jull-taragan/Hardware/resources/300ppi/podPinout.png

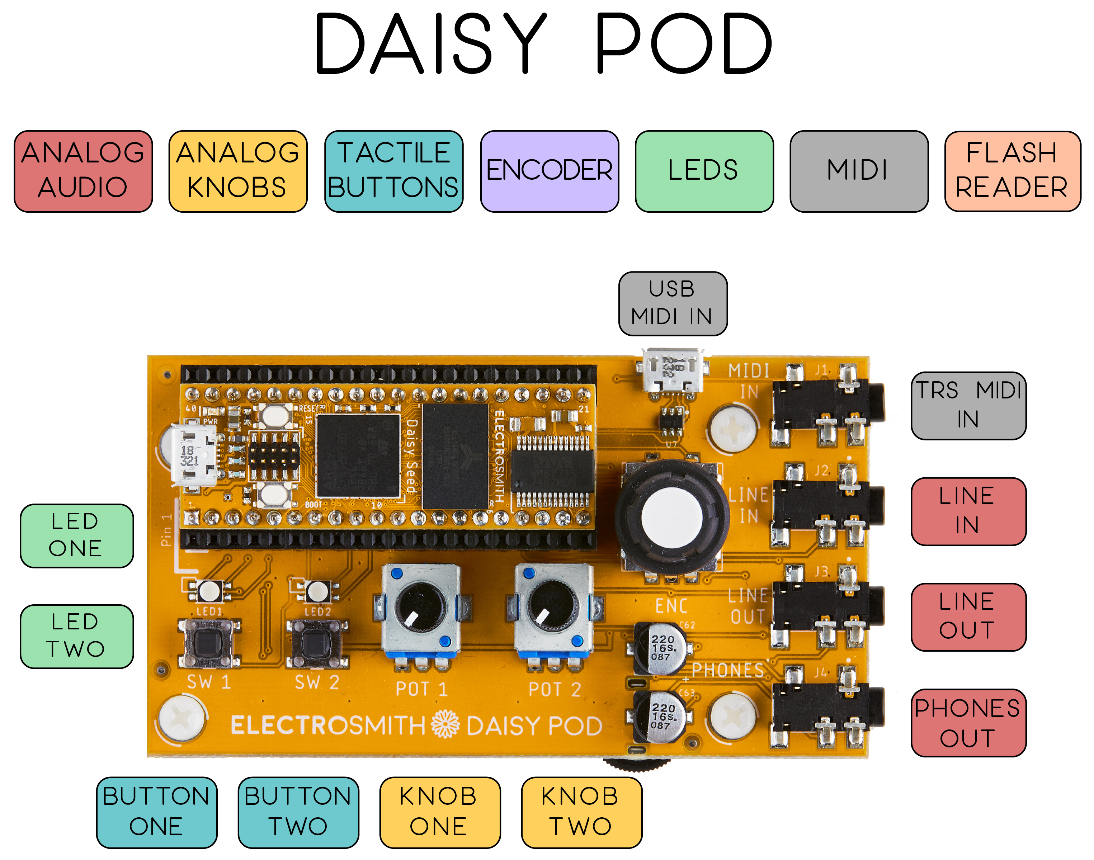
resources/300ppi/podPinout.png
