jull-taragan/Hardware/README.md

## Hardware

Documentation and reference circuits for Electrosmith submodules and boards including the [Daisy Embedded Audio Platform.](https://www.electro-smith.com/daisy)

### Features

- Reference schematics for existing hardware designs

- Documentation including datasheets and app notes

- EAGLE files for hardware examples

- Fritzing breadboard diagrams and schematics (coming soon)

### Getting Started
- Check out our [Getting Started wiki page](https://github.com/electro-smith/DaisyWiki/wiki/1.-Getting-Started)
- Make some sound!

### Contributing

Here are some ways that you can get involved:
- Proof read the documentation and suggest improvements
- Make Fritzing breadboard diagrams for common circuits
- Submit your own hardware examples for inclusion to the repo

### Support

Here are some ways to get support and connect with other users and developers:

- [Make an issue](https://github.com/electro-smith/hardware/issues) 

- Slack Workspace - shoot us an email at hello(at)electro-smith(dot)com to receive an invitation

- Tech Support - for the best response, please use our [contact form](https://www.electro-smith.com/contact)

- Forum (Coming soon)

### License
This repository is licensed with the permissive MIT open source license. 

This allows for modification and reuse in both commercial and personal projects. 
It does not provide a warranty of any kind. 

For the full license, read the [LICENSE](https://github.com/electro-smith/hardware/blob/master/LICENSE) file in the root directory.
