jull-taragan/Hardware/(list of files, drawings)

Other design files:
examples/DaisySeedBlink.fzz
