jull-taragan/Hardware/reference/daisy_patch/ES_Daisy_Patch_Rev4.sch

## EAGLE design reference/daisy_patch/ES_Daisy_Patch_Rev4.sch (2020-06-08)

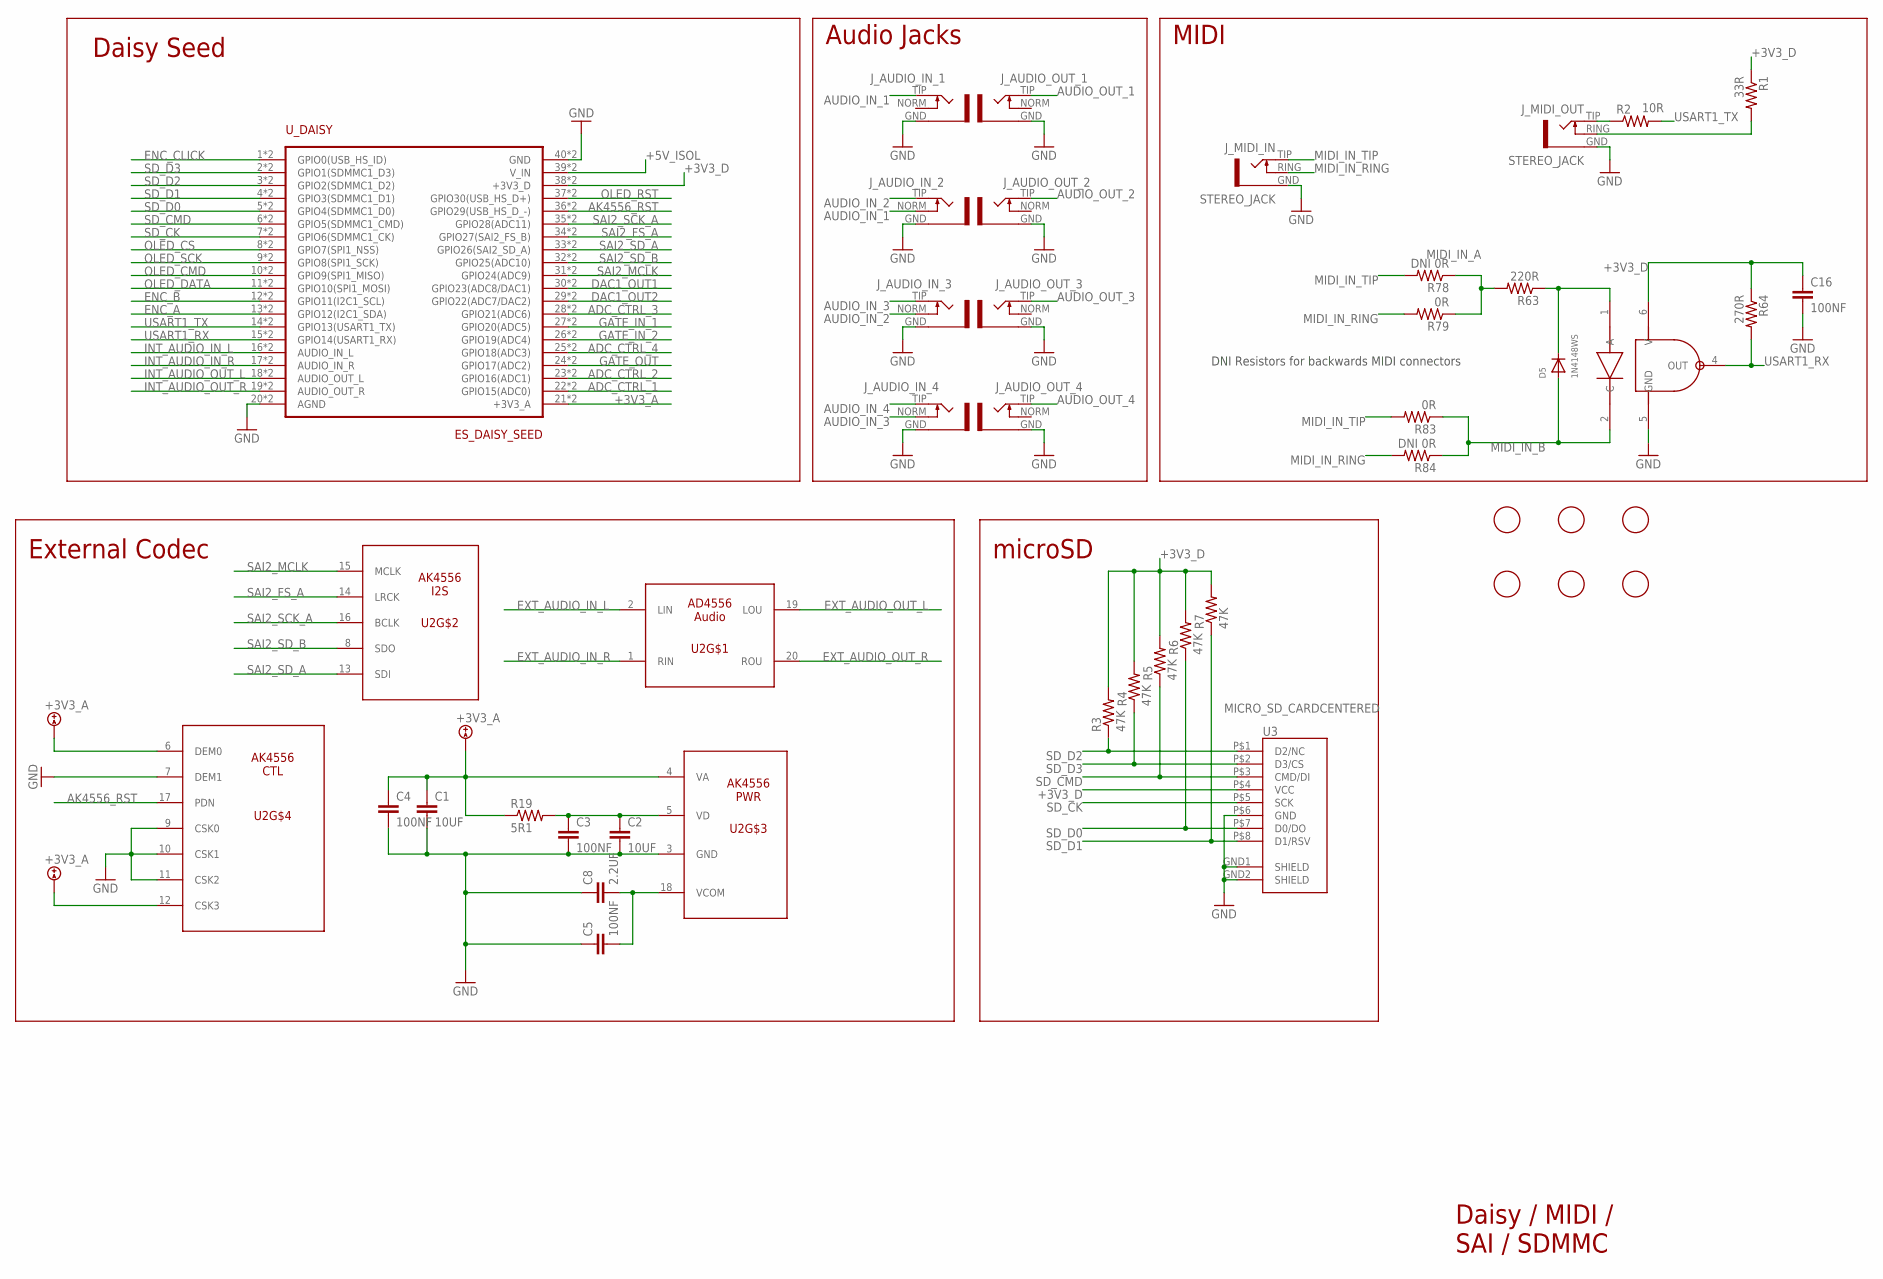
[picture p2: schematic ES_Daisy_Patch_Rev4.sch, sheet 1]

Parts:
C1, C2: 10UF; C0805
C3, C4, C5, C16: 100NF; C0603
C8: 2.2UF; C0603
D5: 1N4148WS; SOD-323F
FD1, FD2, FD3, FD4, FD5, FD6: FIDUCIAL; FIDUCIAL_1MM
J_AUDIO_IN_1, J_AUDIO_IN_2, J_AUDIO_IN_3, J_AUDIO_IN_4: EURO_JACK; S_JACK
J_AUDIO_OUT_1, J_AUDIO_OUT_2, J_AUDIO_OUT_3, J_AUDIO_OUT_4: EURO_JACK; S_JACK
J_MIDI_IN: STEREO_JACK; STEREO_JACK_3.5MM
J_MIDI_OUT: STEREO_JACK; STEREO_JACK_3.5MM
R1: 33R; R0603
R2: 10R; R0603
R3, R4, R5, R6, R7: 47K; R0603
R19: 5R1; R0603
R63: 220R; R0603
R64: 270R; R0603
R78, R84: DNI 0R; R0603
R79, R83: 0R; R0603
U2: AK4556; TSSOP20
U3: MICRO_SD_CARDCENTERED; VERT_MICROSD_CENTERED
U15: OPTOISOLATOR_H11L1M; DIL06_GULLWING
U_DAISY: ES_DAISY_SEED; ES_DAISY_SEED_DOUBLE

Connections:
+3V3_A: C1.1, C4.1, R19.1, U2.4 (VA), U2.6 (DEM0), U2.12 (CSK3), U_DAISY.21 (+3V3_A)
+3V3_D: C16.1, R1.1, R3.2, R4.2, R5.2, R6.2, R7.2, R64.1, U3.P$4 (VCC), U15.6 (V), U_DAISY.38 (+3V3_D)
+5V_ISOL: U_DAISY.39 (V_IN)
ADC_CTRL_1: U_DAISY.22 (GPIO15(ADC0))
ADC_CTRL_2: U_DAISY.23 (GPIO16(ADC1))
ADC_CTRL_3: U_DAISY.28 (GPIO21(ADC6))
ADC_CTRL_4: U_DAISY.25 (GPIO18(ADC3))
AK4556_RST: U2.17 (PDN), U_DAISY.36 (GPIO29(USB_HS_D_-))
AUDIO_IN_1: J_AUDIO_IN_1.TIP, J_AUDIO_IN_2.NORM
AUDIO_IN_2: J_AUDIO_IN_2.TIP, J_AUDIO_IN_3.NORM
AUDIO_IN_3: J_AUDIO_IN_3.TIP, J_AUDIO_IN_4.NORM
AUDIO_IN_4: J_AUDIO_IN_4.TIP
AUDIO_OUT_1: J_AUDIO_OUT_1.TIP
AUDIO_OUT_2: J_AUDIO_OUT_2.TIP
AUDIO_OUT_3: J_AUDIO_OUT_3.TIP
AUDIO_OUT_4: J_AUDIO_OUT_4.TIP
DAC1_OUT1: U_DAISY.30 (GPIO23(ADC8/DAC1))
DAC1_OUT2: U_DAISY.29 (GPIO22(ADC7/DAC2))
ENC_A: U_DAISY.13 (GPIO12(I2C1_SDA))
ENC_B: U_DAISY.12 (GPIO11(I2C1_SCL))
ENC_CLICK: U_DAISY.1 (GPIO0(USB_HS_ID))
EXT_AUDIO_IN_L: U2.2 (LIN)
EXT_AUDIO_IN_R: U2.1 (RIN)
EXT_AUDIO_OUT_L: U2.19 (LOU)
EXT_AUDIO_OUT_R: U2.20 (ROU)
GATE_IN_1: U_DAISY.27 (GPIO20(ADC5))
GATE_IN_2: U_DAISY.26 (GPIO19(ADC4))
GATE_OUT: U_DAISY.24 (GPIO17(ADC2))
GND: C1.2, C2.2, C3.2, C4.2, C5.1, C8.1, C16.2, J_AUDIO_IN_1.GND, J_AUDIO_IN_2.GND, J_AUDIO_IN_3.GND, J_AUDIO_IN_4.GND, J_AUDIO_OUT_1.GND, J_AUDIO_OUT_2.GND, J_AUDIO_OUT_3.GND, J_AUDIO_OUT_4.GND, J_MIDI_IN.GND, J_MIDI_OUT.GND, U2.3 (GND), U2.7 (DEM1), U2.9 (CSK0), U2.10 (CSK1), U2.11 (CSK2), U3.GND1 (SHIELD), U3.GND2 (SHIELD), U3.P$6 (GND), U15.5 (GND), U_DAISY.20 (AGND), U_DAISY.40 (GND)
INT_AUDIO_IN_L: U_DAISY.16 (AUDIO_IN_L)
INT_AUDIO_IN_R: U_DAISY.17 (AUDIO_IN_R)
INT_AUDIO_OUT_L: U_DAISY.18 (AUDIO_OUT_L)
INT_AUDIO_OUT_R: U_DAISY.19 (AUDIO_OUT_R)
MIDI_IN_A: R63.2, R78.1, R79.1
MIDI_IN_B: D5.A, R83.1, R84.1, U15.2 (C)
MIDI_IN_RING: J_MIDI_IN.RING (NORM), R79.2, R84.2
MIDI_IN_TIP: J_MIDI_IN.TIP, R78.2, R83.2
unnamed: J_MIDI_OUT.TIP, R2.1
unnamed: J_MIDI_OUT.RING (NORM), R1.2
unnamed: C2.1, C3.1, R19.2, U2.5 (VD)
unnamed: C5.2, C8.2, U2.18 (VCOM)
unnamed: D5.C, R63.1, U15.1 (A)
OLED_CMD: U_DAISY.10 (GPIO9(SPI1_MISO))
OLED_CS: U_DAISY.8 (GPIO7(SPI1_NSS))
OLED_DATA: U_DAISY.11 (GPIO10(SPI1_MOSI))
OLED_RST: U_DAISY.37 (GPIO30(USB_HS_D+))
OLED_SCK: U_DAISY.9 (GPIO8(SPI1_SCK))
SAI2_FS_A: U2.14 (LRCK), U_DAISY.34 (GPIO27(SAI2_FS_B))
SAI2_MCLK: U2.15 (MCLK), U_DAISY.31 (GPIO24(ADC9))
SAI2_SCK_A: U2.16 (BCLK), U_DAISY.35 (GPIO28(ADC11))
SAI2_SD_A: U2.13 (SDI), U_DAISY.33 (GPIO26(SAI2_SD_A))
SAI2_SD_B: U2.8 (SDO), U_DAISY.32 (GPIO25(ADC10))
SD_CK: U3.P$5 (SCK), U_DAISY.7 (GPIO6(SDMMC1_CK))
SD_CMD: R5.1, U3.P$3 (CMD/DI), U_DAISY.6 (GPIO5(SDMMC1_CMD))
SD_D0: R6.1, U3.P$7 (D0/DO), U_DAISY.5 (GPIO4(SDMMC1_D0))
SD_D1: R7.1, U3.P$8 (D1/RSV), U_DAISY.4 (GPIO3(SDMMC1_D1))
SD_D2: R3.1, U3.P$1 (D2/NC), U_DAISY.3 (GPIO2(SDMMC1_D2))
SD_D3: R4.1, U3.P$2 (D3/CS), U_DAISY.2 (GPIO1(SDMMC1_D3))
USART1_RX: R64.2, U15.4 (OUT), U_DAISY.15 (GPIO14(USART1_RX))
USART1_TX: R2.2, U_DAISY.14 (GPIO13(USART1_TX))

Notes on the sheet:
Daisy Seed
Audio Jacks
External Codec
MIDI
microSD
Daisy / MIDI / SAI / SDMMC
DNI Resistors for backwards MIDI connectors

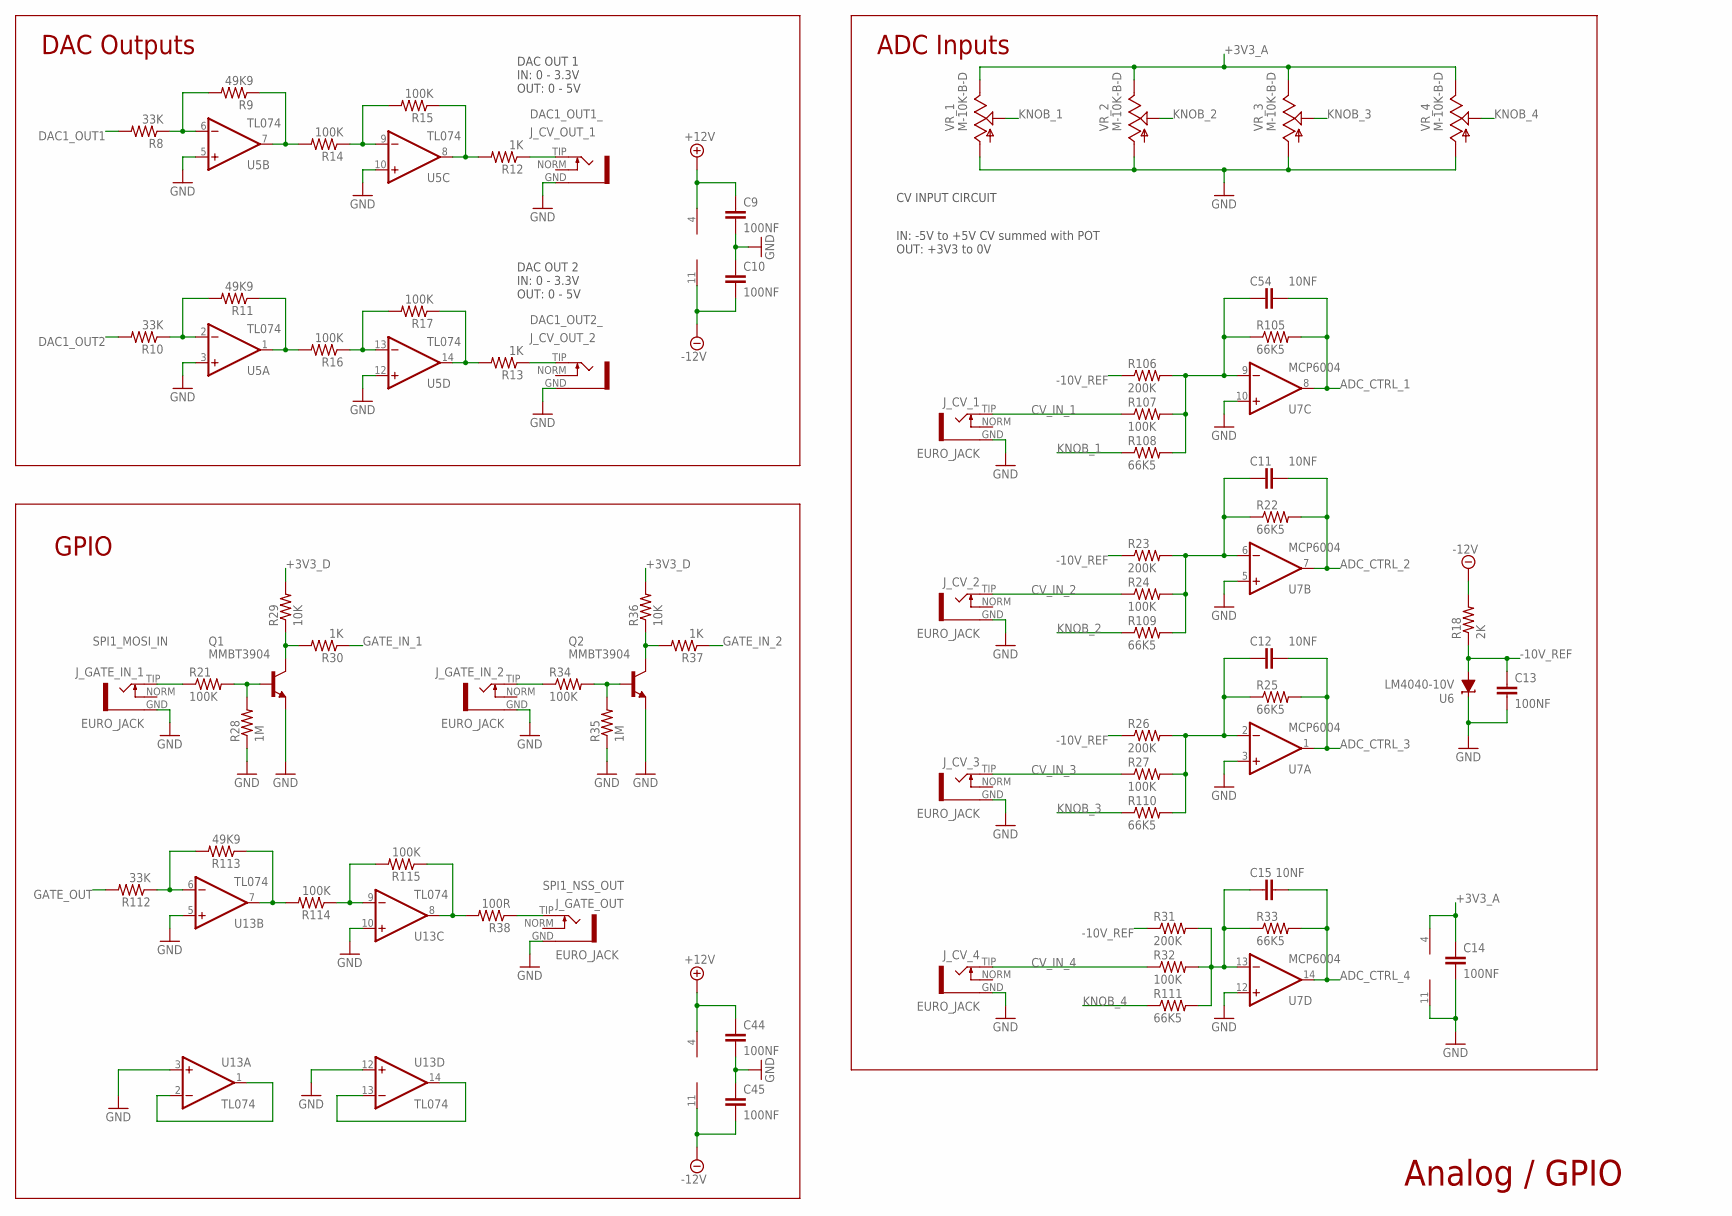
[picture p3: schematic ES_Daisy_Patch_Rev4.sch, sheet 2]

Parts:
C9, C10, C13, C14, C44, C45: 100NF; C0603
C11, C12, C15, C54: 10NF; C0603
J_CV_1, J_CV_2, J_CV_3, J_CV_4: EURO_JACK; S_JACK
J_CV_OUT_1, J_CV_OUT_2: EURO_JACK; S_JACK
J_GATE_IN_1, J_GATE_IN_2: EURO_JACK; S_JACK
J_GATE_OUT: EURO_JACK; S_JACK
Q1, Q2: MMBT3904; SOT23-BEC
R8, R10, R112: 33K; R0603
R9, R11, R113: 49K9; R0603
R12, R13, R30, R37: 1K; R0603
R14, R15, R16, R17, R21, R24, R27, R32, R34, R107, R114, R115: 100K; R0603
R18: 2K; R0603
R22, R25, R33, R105, R108, R109, R110, R111: 66K5; R0603
R23, R26, R31, R106: 200K; R0603
R28, R35: 1M; R0603
R29, R36: 10K; R0603
R38: 100R; R0603
U5, U13: TL074; TSSOP-14
U6: LM4040-10V; DBZ_R-PDSO-G3
U7: MCP6004; TSSOP-14
VR_1, VR_2, VR_3, VR_4: M-10K-B-D; 9MM_SNAP-IN_POT_SILK

Connections:
+3V3_A: C14.1, U7.4 (V+), VR_1.3, VR_2.3, VR_3.3, VR_4.3
+3V3_D: R29.2, R36.2
+12V: C9.1, C44.1, U5.4 (V+), U13.4 (V+)
-10V_REF: C13.1, R18.1, R23.1, R26.1, R31.1, R106.1, U6.2 (A)
-12V: C10.2, C45.2, R18.2, U5.11 (V-), U13.11 (V-)
ADC_CTRL_1: C54.2, R105.2, U7.8 (OUT)
ADC_CTRL_2: C11.2, R22.2, U7.7 (OUT)
ADC_CTRL_3: C12.2, R25.2, U7.1 (OUT)
ADC_CTRL_4: C15.2, R33.2, U7.14 (OUT)
CV_IN_1: J_CV_1.TIP, R107.1
CV_IN_2: J_CV_2.TIP, R24.1
CV_IN_3: J_CV_3.TIP, R27.1
CV_IN_4: J_CV_4.TIP, R32.1
DAC1_OUT1: R8.2
DAC1_OUT1_: J_CV_OUT_1.TIP, R12.1
DAC1_OUT2: R10.2
DAC1_OUT2_: J_CV_OUT_2.TIP, R13.1
GATE_IN_1: R30.1
GATE_IN_2: R37.1
GATE_OUT: R112.2
GND: C9.2, C10.1, C13.2, C14.2, C44.2, C45.1, J_CV_1.GND, J_CV_2.GND, J_CV_3.GND, J_CV_4.GND, J_CV_OUT_1.GND, J_CV_OUT_2.GND, J_GATE_IN_1.GND, J_GATE_IN_2.GND, J_GATE_OUT.GND, Q1.E, Q2.E, R28.1, R35.1, U5.3 (+IN), U5.5 (+IN), U5.10 (+IN), U5.12 (+IN), U6.1 (C), U7.3 (+IN), U7.5 (+IN), U7.10 (+IN), U7.11 (V-), U7.12 (+IN), U13.3 (+IN), U13.5 (+IN), U13.10 (+IN), U13.12 (+IN), VR_1.1, VR_2.1, VR_3.1, VR_4.1
KNOB_1: R108.1, VR_1.2
KNOB_2: R109.1, VR_2.2
KNOB_3: R110.1, VR_3.2
KNOB_4: R111.1, VR_4.2
unnamed: R14.1, R15.2, U5.9 (-IN)
unnamed: R12.2, R15.1, U5.8 (OUT)
unnamed: R8.1, R9.2, U5.6 (-IN)
unnamed: R9.1, R14.2, U5.7 (OUT)
unnamed: C54.1, R105.1, R106.2, R107.2, R108.2, U7.9 (-IN)
unnamed: R10.1, R11.2, U5.2 (-IN)
unnamed: R11.1, R16.2, U5.1 (OUT)
unnamed: R112.1, R113.2, U13.6 (-IN)
unnamed: R16.1, R17.2, U5.13 (-IN)
unnamed: R13.2, R17.1, U5.14 (OUT)
unnamed: U13.1 (OUT), U13.2 (-IN)
unnamed: R113.1, R114.2, U13.7 (OUT)
unnamed: R114.1, R115.2, U13.9 (-IN)
unnamed: R38.2, R115.1, U13.8 (OUT)
unnamed: Q1.C, R29.1, R30.2
unnamed: C11.1, R22.1, R23.2, R24.2, R109.2, U7.6 (-IN)
unnamed: Q2.B, R34.2, R35.2
unnamed: C12.1, R25.1, R26.2, R27.2, R110.2, U7.2 (-IN)
unnamed: Q1.B, R21.2, R28.2
unnamed: Q2.C, R36.1, R37.2
unnamed: C15.1, R31.2, R32.2, R33.1, R111.2, U7.13 (-IN)
unnamed: U13.13 (-IN), U13.14 (OUT)
SPI1_MISO_IN: J_GATE_IN_2.TIP, R34.1
SPI1_MOSI_IN: J_GATE_IN_1.TIP, R21.1
SPI1_NSS_OUT: J_GATE_OUT.TIP, R38.1

Notes on the sheet:
DAC Outputs
DAC OUT 1 IN: 0 - 3.3V OUT: 0 - 5V
DAC OUT 2 IN: 0 - 3.3V OUT: 0 - 5V
ADC Inputs
GPIO
IN: -5V to +5V CV summed with POT OUT: +3V3 to 0V
CV INPUT CIRCUIT
Analog / GPIO

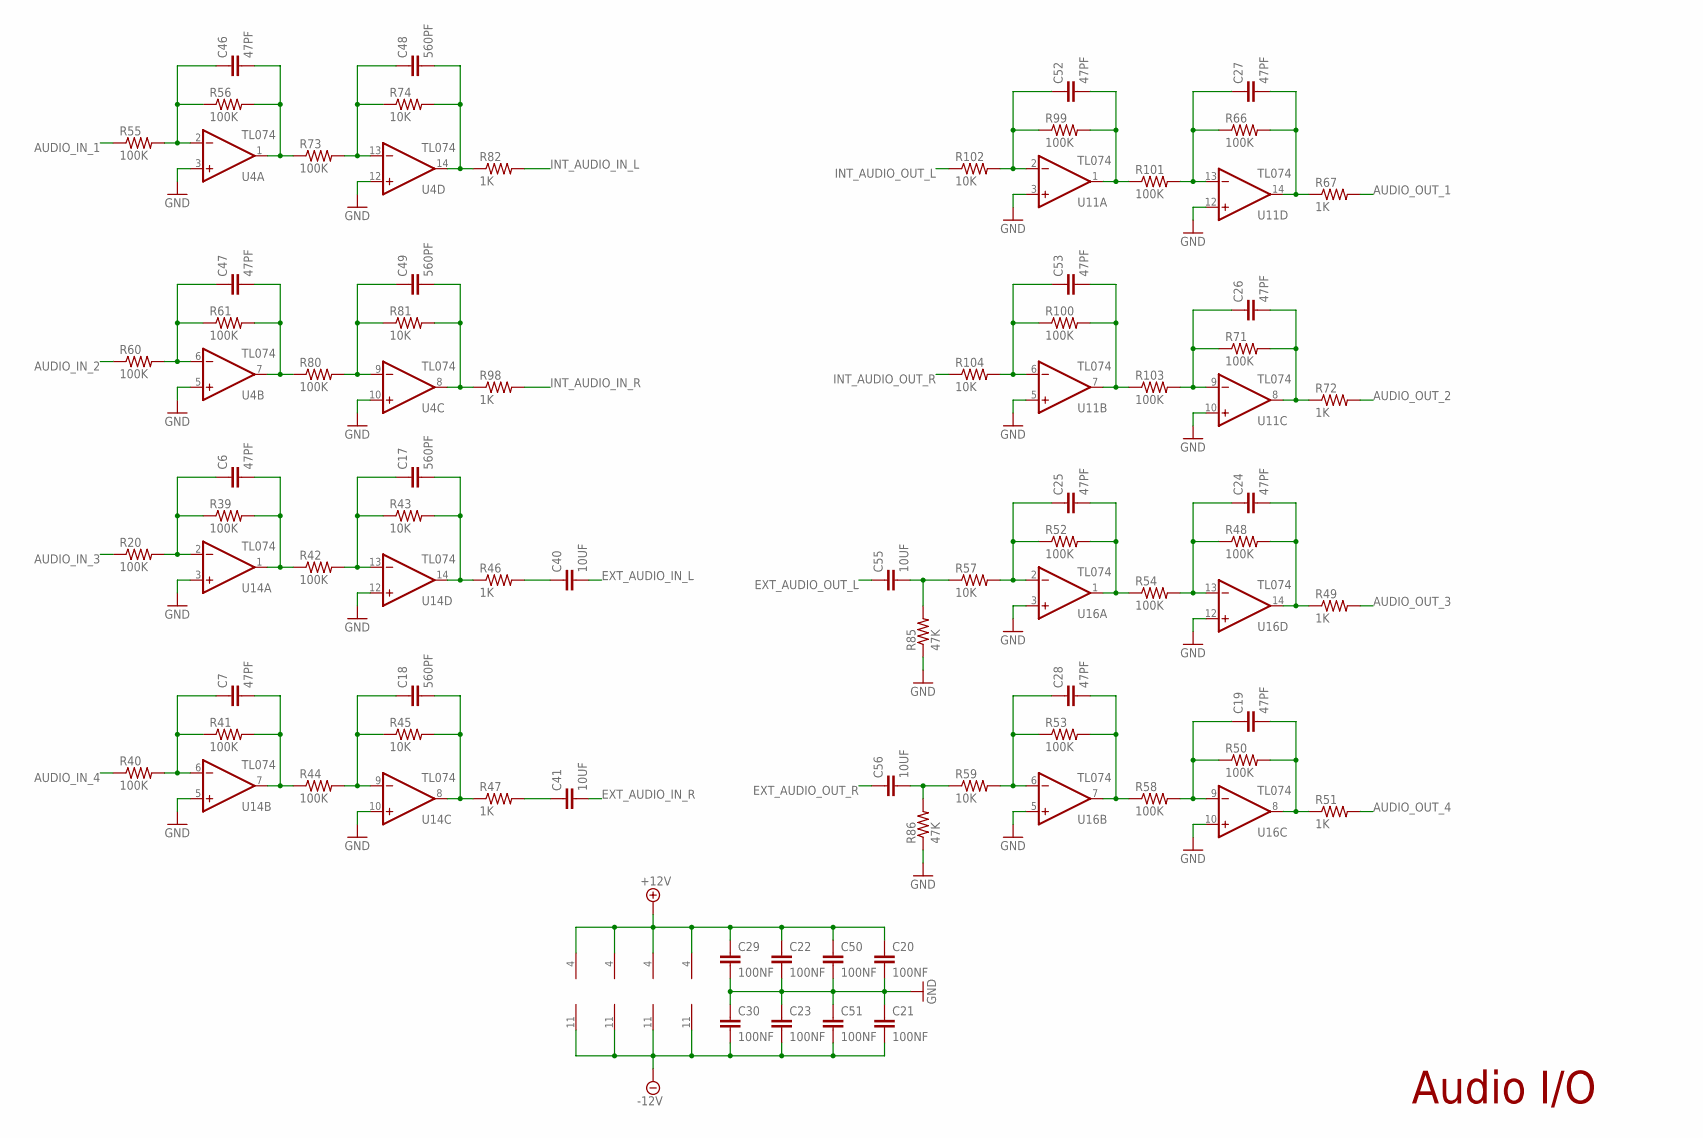
[picture p4: schematic ES_Daisy_Patch_Rev4.sch, sheet 3]

Parts:
C6, C7, C19, C24, C25, C26, C27, C28, C46, C47, C52, C53: 47PF; C0603
C17, C18, C48, C49: 560PF; C0603
C20, C21, C22, C23, C29, C30, C50, C51: 100NF; C0603
C40, C41, C55, C56: 10UF; C0805
R20, R39, R40, R41, R42, R44, R48, R50, R52, R53, R54, R55, R56, R58, R60, R61, R66, R71, R73, R80, R99, R100, R101, R103: 100K; R0603
R43, R45, R57, R59, R74, R81, R102, R104: 10K; R0603
R46, R47, R49, R51, R67, R72, R82, R98: 1K; R0603
R85, R86: 47K; R0603
U4, U11, U14, U16: TL074; TSSOP-14

Connections:
+12V: C20.1, C22.1, C29.1, C50.1, U4.4 (V+), U11.4 (V+), U14.4 (V+), U16.4 (V+)
-12V: C21.2, C23.2, C30.2, C51.2, U4.11 (V-), U11.11 (V-), U14.11 (V-), U16.11 (V-)
AUDIO_IN_1: R55.1
AUDIO_IN_2: R60.1
AUDIO_IN_3: R20.1
AUDIO_IN_4: R40.1
AUDIO_OUT_1: R67.2
AUDIO_OUT_2: R72.2
AUDIO_OUT_3: R49.2
AUDIO_OUT_4: R51.2
EXT_AUDIO_IN_L: C40.2
EXT_AUDIO_IN_R: C41.2
EXT_AUDIO_OUT_L: C55.1
EXT_AUDIO_OUT_R: C56.1
GND: C20.2, C21.1, C22.2, C23.1, C29.2, C30.1, C50.2, C51.1, R85.1, R86.1, U4.3 (+IN), U4.5 (+IN), U4.10 (+IN), U4.12 (+IN), U11.3 (+IN), U11.5 (+IN), U11.10 (+IN), U11.12 (+IN), U14.3 (+IN), U14.5 (+IN), U14.10 (+IN), U14.12 (+IN), U16.3 (+IN), U16.5 (+IN), U16.10 (+IN), U16.12 (+IN)
INT_AUDIO_IN_L: R82.2
INT_AUDIO_IN_R: R98.2
INT_AUDIO_OUT_L: R102.1
INT_AUDIO_OUT_R: R104.1
unnamed: C40.1, R46.2
unnamed: C7.1, R40.2, R41.1, U14.6 (-IN)
unnamed: C7.2, R41.2, R44.1, U14.7 (OUT)
unnamed: C48.1, R73.2, R74.1, U4.13 (-IN)
unnamed: C6.1, R20.2, R39.1, U14.2 (-IN)
unnamed: C6.2, R39.2, R42.1, U14.1 (OUT)
unnamed: C17.1, R42.2, R43.1, U14.13 (-IN)
unnamed: C18.1, R44.2, R45.1, U14.9 (-IN)
unnamed: C18.2, R45.2, R47.1, U14.8 (OUT)
unnamed: C17.2, R43.2, R46.1, U14.14 (OUT)
unnamed: C19.1, R50.1, R58.2, U16.9 (-IN)
unnamed: C19.2, R50.2, R51.1, U16.8 (OUT)
unnamed: C24.1, R48.1, R54.2, U16.13 (-IN)
unnamed: C24.2, R48.2, R49.1, U16.14 (OUT)
unnamed: C25.1, R52.1, R57.2, U16.2 (-IN)
unnamed: C25.2, R52.2, R54.1, U16.1 (OUT)
unnamed: C28.1, R53.1, R59.2, U16.6 (-IN)
unnamed: C28.2, R53.2, R58.1, U16.7 (OUT)
unnamed: C41.1, R47.2
unnamed: C55.2, R57.1, R85.2
unnamed: C56.2, R59.1, R86.2
unnamed: C46.1, R55.2, R56.1, U4.2 (-IN)
unnamed: C46.2, R56.2, R73.1, U4.1 (OUT)
unnamed: C47.1, R60.2, R61.1, U4.6 (-IN)
unnamed: C47.2, R61.2, R80.1, U4.7 (OUT)
unnamed: C27.1, R66.1, R101.2, U11.13 (-IN)
unnamed: C27.2, R66.2, R67.1, U11.14 (OUT)
unnamed: C49.1, R80.2, R81.1, U4.9 (-IN)
unnamed: C26.1, R71.1, R103.2, U11.9 (-IN)
unnamed: C26.2, R71.2, R72.1, U11.8 (OUT)
unnamed: C49.2, R81.2, R98.1, U4.8 (OUT)
unnamed: C48.2, R74.2, R82.1, U4.14 (OUT)
unnamed: C52.1, R99.1, R102.2, U11.2 (-IN)
unnamed: C52.2, R99.2, R101.1, U11.1 (OUT)
unnamed: C53.1, R100.1, R104.2, U11.6 (-IN)
unnamed: C53.2, R100.2, R103.1, U11.7 (OUT)

Notes on the sheet:
Audio I/O

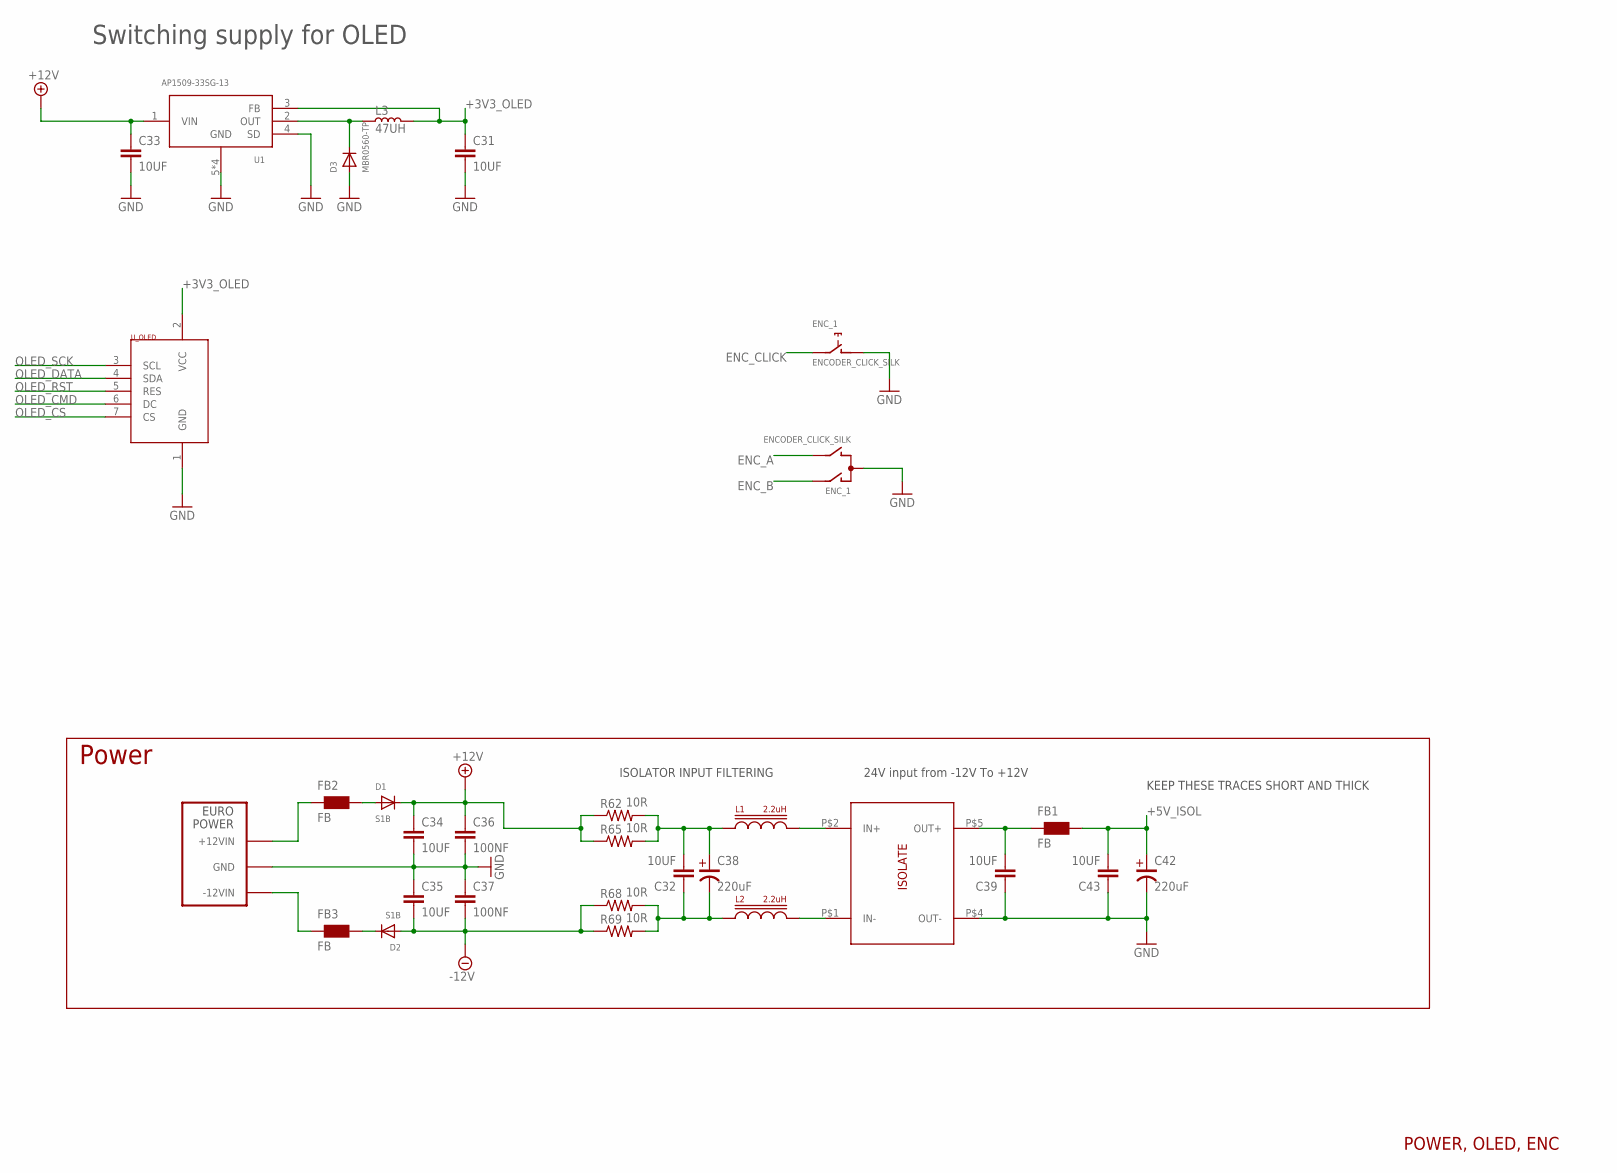
[picture p5: schematic ES_Daisy_Patch_Rev4.sch, sheet 4]

Parts:
C31, C32, C33, C34, C35, C39, C43: 10UF; C0805
C36, C37: 100NF; C0603
C38, C42: 220uF; PANASONIC_D
D1, D2: S1B; SMADIODE
D3: MBR0560-TP; SOD-123
ENC_1: ENCODER_CLICK_SILK; PEC11_SILK
EP1: EURORACK_POWERSMT; EURORACK_POWER_SMT
FB1, FB2, FB3: FB; WUERTH-ELEKTRONIK_0603
L1, L2: 2.2uH; BOURNS_SRP2010
L3: 47UH; SRN3015TA
R62, R65, R68, R69: 10R; R0603
U1: AP1509-33SG-13; SO-8
U$1: POWER_ISOLATE; XP_POWER_ISEXXXXA
U_OLED: OLED_DISPLAY; ER-OLEDM015-2

Connections:
+3V3_OLED: C31.1, L3.P$2, U1.3 (FB), U_OLED.2 (VCC)
+5V_ISOL: C42.+ (POS), C43.2, FB1.2
+12V: C33.1, C34.1, C36.1, D1.C, R62.1, R65.1, U1.1 (VIN)
-12V: C35.2, C37.2, D2.A, R68.1, R69.1
ENC_A: ENC_1.B
ENC_B: ENC_1.A
ENC_CLICK: ENC_1.E (2)
GND: C31.2, C33.2, C34.2, C35.1, C36.2, C37.1, C39.1, C42.- (NEG), C43.1, D3.A, ENC_1.C, ENC_1.D (1), EP1.GND1A (GND), U1.4 (SD), U1.5 (GND), U$1.P$4 (OUT-), U_OLED.1 (GND)
unnamed: C39.2, FB1.1, U$1.P$5 (OUT+)
unnamed: L1.P$2, U$1.P$2 (IN+)
unnamed: L2.P$2, U$1.P$1 (IN-)
unnamed: C32.2, C38.+ (POS), L1.P$1, R62.2, R65.2
unnamed: C32.1, C38.- (NEG), L2.P$1, R68.2, R69.2
unnamed: EP1.P12VA (+12VIN), FB2.1
unnamed: D3.C, L3.P$1, U1.2 (OUT)
unnamed: EP1.N12VA (-12VIN), FB3.1
unnamed: D1.A, FB2.2
unnamed: D2.C, FB3.2
OLED_CMD: U_OLED.6 (DC)
OLED_CS: U_OLED.7 (CS)
OLED_DATA: U_OLED.4 (SDA)
OLED_RST: U_OLED.5 (RES)
OLED_SCK: U_OLED.3 (SCL)

Notes on the sheet:
Power
ISOLATOR INPUT FILTERING
24V input from -12V To +12V
KEEP THESE TRACES SHORT AND THICK
Switching supply for OLED
POWER, OLED, ENC
