jull-taragan/Hardware/reference/daisy_pod/ES_Daisy_Pod_Rev3.sch

## EAGLE design reference/daisy_pod/ES_Daisy_Pod_Rev3.sch (2020-06-26)

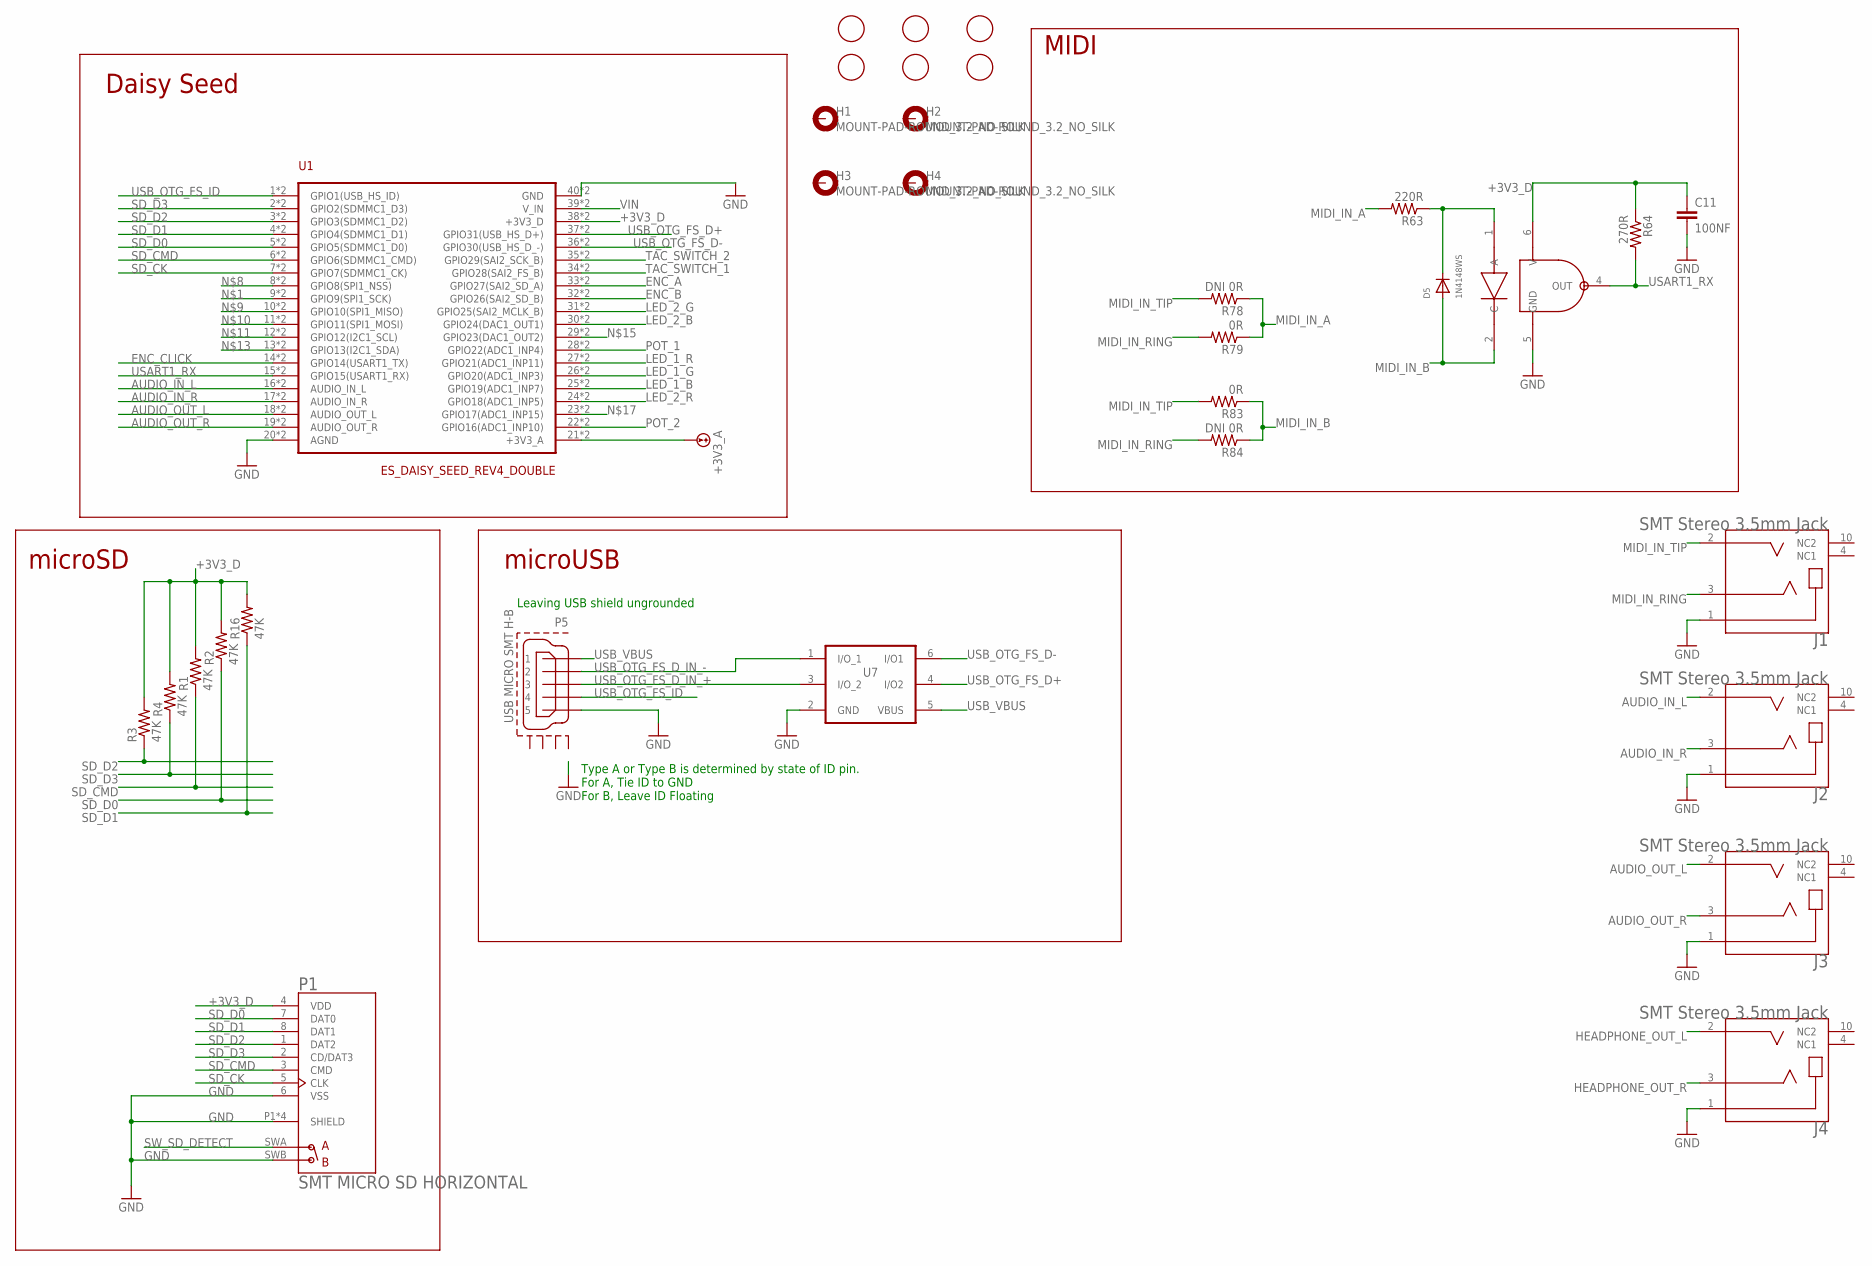
[picture p6: schematic ES_Daisy_Pod_Rev3.sch, sheet 1]

Parts:
C11: 100NF; C0603
D5: 1N4148WS; SOD-323F
FD1, FD2, FD3, FD4, FD5, FD6: FIDUCIAL; FIDUCIAL_1MM
H1, H2, H3, H4: MOUNT-PAD-ROUND_3.2_NO_SILK; 32-PAD_NO_SILK
J1, J2, J3, J4: SMT Stereo 3.5mm Jack; CUI_SJ2-35863B1-SMT-TR
P1: SMT MICRO SD HORIZONTAL; HRS_DM3AT-SF-PEJM5
P5: USB MICRO SMT H-B; 47589-0001_CUT
R1, R2, R3, R4, R16: 47K; R0603
R63: 220R; R0603
R64: 270R; R0603
R78, R84: DNI 0R; R0603
R79, R83: 0R; R0603
U1: ES_DAISY_SEED_REV4_DOUBLE; ES_DAISY_SEED_DOUBLE
U7: USBLC6 TVS SOT-23-6; SOT-23-6L
U15: H11L1SR2M; DIL06_GULLWING

Connections:
+3V3_A: U1.21 (+3V3_A)
+3V3_D: C11.1, P1.4 (VDD), R1.2, R2.2, R3.2, R4.2, R16.2, R64.1, U1.38 (+3V3_D), U15.6 (V)
AUDIO_IN_L: J2.2 (TIP), U1.16 (AUDIO_IN_L)
AUDIO_IN_R: J2.3 (RING), U1.17 (AUDIO_IN_R)
AUDIO_OUT_L: J3.2 (TIP), U1.18 (AUDIO_OUT_L)
AUDIO_OUT_R: J3.3 (RING), U1.19 (AUDIO_OUT_R)
ENC_A: U1.33 (GPIO27(SAI2_SD_A))
ENC_B: U1.32 (GPIO26(SAI2_SD_B))
ENC_CLICK: U1.14 (GPIO14(USART1_TX))
GND: C11.2, J1.1 (SLEEVE), J2.1 (SLEEVE), J3.1 (SLEEVE), J4.1 (SLEEVE), P1.6 (VSS), P1.P1 (SHIELD), P1.SWB (B), P5.5, U1.20 (AGND), U1.40 (GND), U7.2 (GND), U15.5 (GND)
HEADPHONE_OUT_L: J4.2 (TIP)
HEADPHONE_OUT_R: J4.3 (RING)
LED_1_B: U1.25 (GPIO19(ADC1_INP7))
LED_1_G: U1.26 (GPIO20(ADC1_INP3))
LED_1_R: U1.27 (GPIO21(ADC1_INP11))
LED_2_B: U1.30 (GPIO24(DAC1_OUT1))
LED_2_G: U1.31 (GPIO25(SAI2_MCLK_B))
LED_2_R: U1.24 (GPIO18(ADC1_INP5))
MIDI_IN_A: R63.2, R78.1, R79.1
MIDI_IN_B: D5.A, R83.1, R84.1, U15.2 (C)
MIDI_IN_RING: J1.3 (RING), R79.2, R84.2
MIDI_IN_TIP: J1.2 (TIP), R78.2, R83.2
unnamed: D5.C, R63.1, U15.1 (A)
POT_1: U1.28 (GPIO22(ADC1_INP4))
POT_2: U1.22 (GPIO16(ADC1_INP10))
SD_CK: P1.5 (CLK), U1.7 (GPIO7(SDMMC1_CK))
SD_CMD: P1.3 (CMD), R1.1, U1.6 (GPIO6(SDMMC1_CMD))
SD_D0: P1.7 (DAT0), R2.1, U1.5 (GPIO5(SDMMC1_D0))
SD_D1: P1.8 (DAT1), R16.1, U1.4 (GPIO4(SDMMC1_D1))
SD_D2: P1.1 (DAT2), R3.1, U1.3 (GPIO3(SDMMC1_D2))
SD_D3: P1.2 (CD/DAT3), R4.1, U1.2 (GPIO2(SDMMC1_D3))
SW_SD_DETECT: P1.SWA (A)
TAC_SWITCH_1: U1.34 (GPIO28(SAI2_FS_B))
TAC_SWITCH_2: U1.35 (GPIO29(SAI2_SCK_B))
USART1_RX: R64.2, U1.15 (GPIO15(USART1_RX)), U15.4 (OUT)
USB_OTG_FS_D+: U1.37 (GPIO31(USB_HS_D+)), U7.4 (I/O2)
USB_OTG_FS_D-: U1.36 (GPIO30(USB_HS_D_-)), U7.6 (I/O1)
USB_OTG_FS_D_IN_+: P5.3, U7.3 (I/O_2)
USB_OTG_FS_D_IN_-: P5.2, U7.1 (I/O_1)
USB_OTG_FS_ID: P5.4, U1.1 (GPIO1(USB_HS_ID))
USB_VBUS: P5.1, U7.5 (VBUS)
VIN: U1.39 (V_IN)

Notes on the sheet:
Daisy Seed
microSD
Type A or Type B is determined by state of ID pin. For A, Tie ID to GND For B, Leave ID Floating
Leaving USB shield ungrounded
microUSB
MIDI

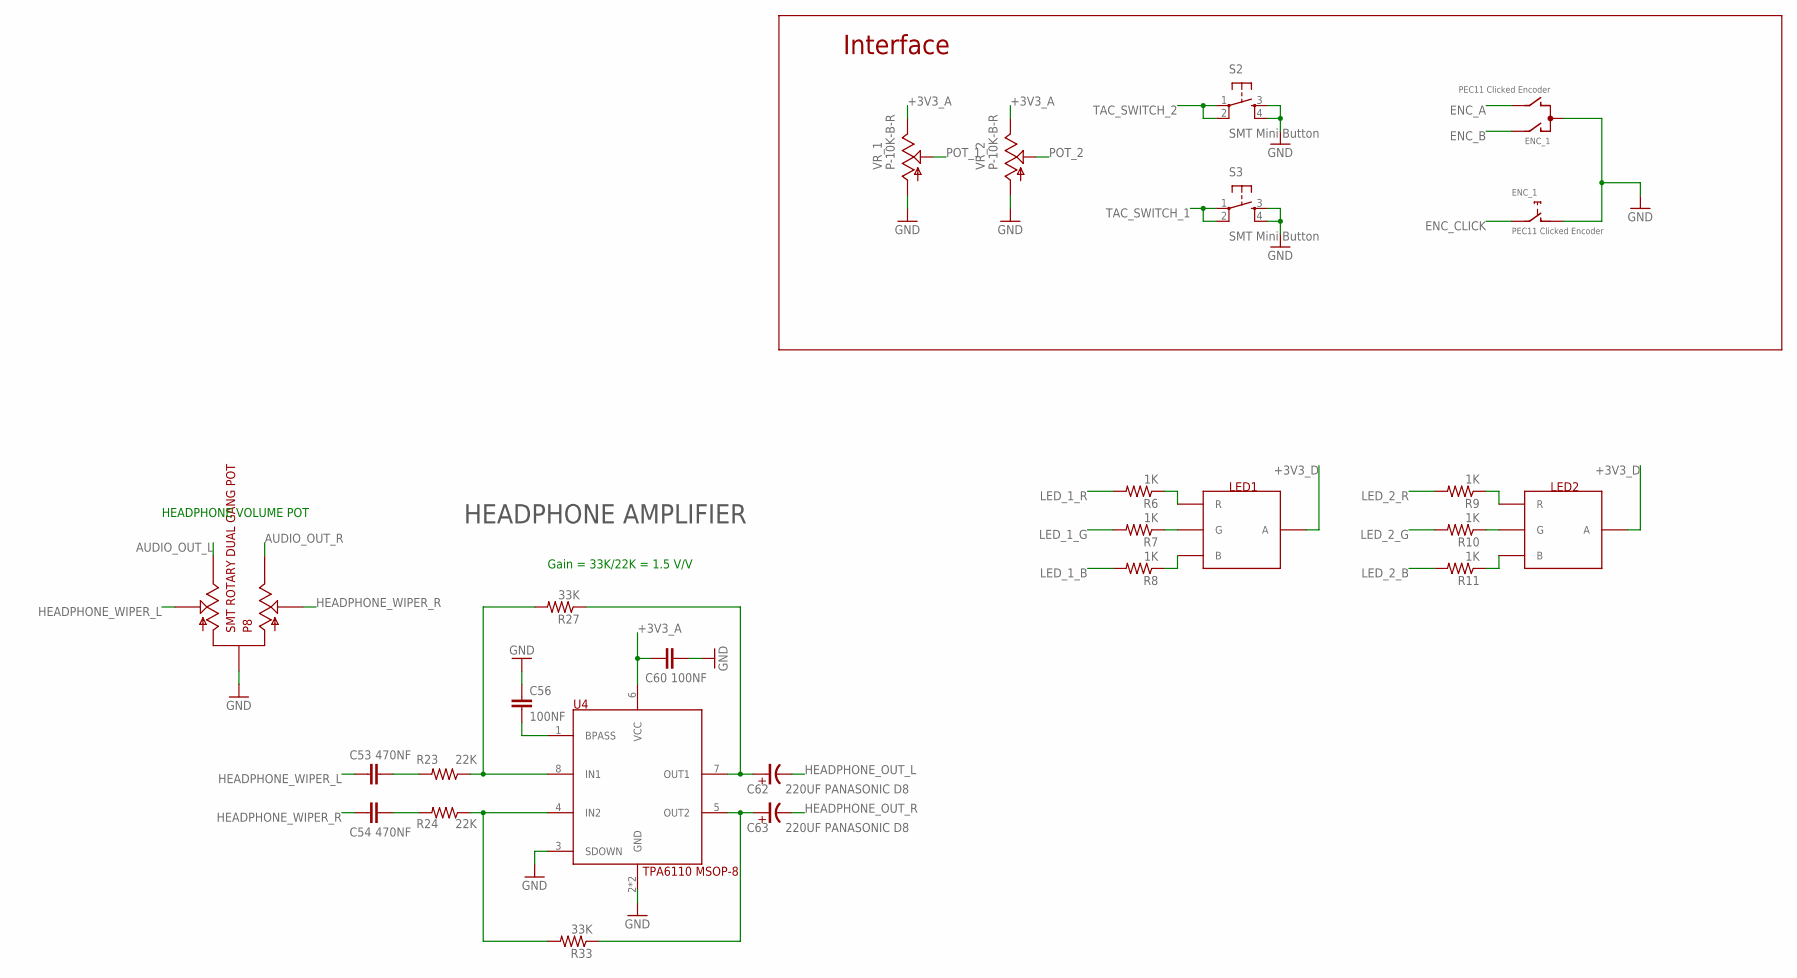
[picture p7: schematic ES_Daisy_Pod_Rev3.sch, sheet 2]

Parts:
C53, C54: 470NF; C0603
C56, C60: 100NF; C0603
C62, C63: 220UF PANASONIC D8; PANASONIC_D
ENC_1: PEC11 Clicked Encoder; PEC11_SILK
LED1, LED2: RGB LED SMT PLCC4; P-LCC-4-3
P8: SMT ROTARY DUAL GANG POT; RK10J12R0A0B
R6, R7, R8, R9, R10, R11: 1K; R0603
R23, R24: 22K; R0603
R27, R33: 33K; R0603
S2, S3: SMT Mini Button; TL3301SPF160QJ
U4: TPA6110 MSOP-8; MSOP_8_PWRPAD
VR_1, VR_2: P-10K-B-R; 9MM_SNAP-IN_POT_SILK

Connections:
+3V3_A: C60.2, U4.6 (VCC), VR_1.3, VR_2.3
+3V3_D: LED1.2 (A), LED2.2 (A)
AUDIO_OUT_L: P8.P$5
AUDIO_OUT_R: P8.P$4
ENC_A: ENC_1.B
ENC_B: ENC_1.A
ENC_CLICK: ENC_1.E (2)
GND: C56.1, C60.1, ENC_1.C, ENC_1.D (1), P8.P$1, S2.3, S2.4, S3.3, S3.4, U4.2 (GND), U4.3 (SDOWN), VR_1.1, VR_2.1
HEADPHONE_OUT_L: C62.- (NEG)
HEADPHONE_OUT_R: C63.- (NEG)
HEADPHONE_WIPER_L: C53.1, P8.P$2
HEADPHONE_WIPER_R: C54.1, P8.P$3
LED_1_B: R8.2
LED_1_G: R7.2
LED_1_R: R6.2
LED_2_B: R11.2
LED_2_G: R10.2
LED_2_R: R9.2
unnamed: LED1.1 (R), R6.1
unnamed: LED1.4 (G), R7.1
unnamed: LED1.3 (B), R8.1
unnamed: LED2.1 (R), R9.1
unnamed: LED2.4 (G), R10.1
unnamed: LED2.3 (B), R11.1
unnamed: C54.2, R24.2
unnamed: R23.1, R27.2, U4.8 (IN1)
unnamed: R24.1, R33.2, U4.4 (IN2)
unnamed: C53.2, R23.2
unnamed: C56.2, U4.1 (BPASS)
unnamed: C62.+ (POS), R27.1, U4.7 (OUT1)
unnamed: C63.+ (POS), R33.1, U4.5 (OUT2)
POT_1: VR_1.2
POT_2: VR_2.2
TAC_SWITCH_1: S3.1, S3.2
TAC_SWITCH_2: S2.1, S2.2

Notes on the sheet:
Interface
HEADPHONE VOLUME POT
HEADPHONE AMPLIFIER
Gain = 33K/22K = 1.5 V/V
