jull-taragan/Hardware/(commit log)

2020-06-04 added eurorack cv input sch and pdf
    [Eurorack_CV_Input.sch]
2020-06-04 added pot in and pot cv summed
    [Eurorack_Pot_CV_Summed.sch, Pot_Input.sch]
2020-06-05 added eurorack audio io
    [Eurorack_Audio_IO.sch]
2020-06-05 finished audio io
    [Eurorack_Audio_IO.sch]
2020-06-05 added gate in
    [Eurorack_Audio_IO.sch, Eurorack_CV_Input.sch, Eurorack_Gate_In.sch, Eurorack_Pot_CV_Summed.sch]
2020-06-05 removed old files
    [Eurorack_Audio_IO.sch, Eurorack_CV_Input.sch, Eurorack_Pot_CV_Summed.sch, Pot_Input.sch]
2020-06-05 Revert "removed old files"
    This reverts commit ea5d9bb200fb49d3c410ad68dc144e0672166bdf.
    [Eurorack_Audio_IO.sch, Eurorack_CV_Input.sch, Eurorack_Pot_CV_Summed.sch, Pot_Input.sch]
2020-06-05 recovered pot input file
    [Eurorack_Audio_IO.sch, Eurorack_CV_Input.sch, Eurorack_Pot_CV_Summed.sch]
2020-06-08 removed old sch files that will be replaced by Patch sch, etc.
    [Eurorack_Audio_IO.sch, Eurorack_CV_Input.sch, Eurorack_Gate_In.sch, Eurorack_Pot_CV_Summed.sch, Pot_Input.sch]
2020-06-08 added patch files
    [ES_Daisy_Patch_Rev4.sch]
2020-06-08 updated Patch sch
    [ES_Daisy_Patch_Rev4.sch]
2020-06-08 renamed eurorack to daisy patch
    [ES_Daisy_Patch_Rev4.sch]
2020-06-08 removed eurorack/
    [ES_Daisy_Patch_Rev4.sch]
2020-06-08 updated Daisy symbol in DaisyPatch sch.
    [ES_Daisy_Patch_Rev4.sch]
2020-06-09 added daisy seed frizting part, and blink example
    [DaisySeedBlink.fzz]
2020-06-26 added pod sch files
    [ES_Daisy_Pod_Rev3.sch]
