jull-taragan/Hardware/(notices)

Notices in the files:
parts and their libraries:
Electrosmith-Connectors: (C) 2014 Tomasz Boleslaw CEDRO, cederom@tlen.pl, http://www.tomek.cedro.info.
